Duckle29/0-10V_window_controller/Hardware/images/bot.png

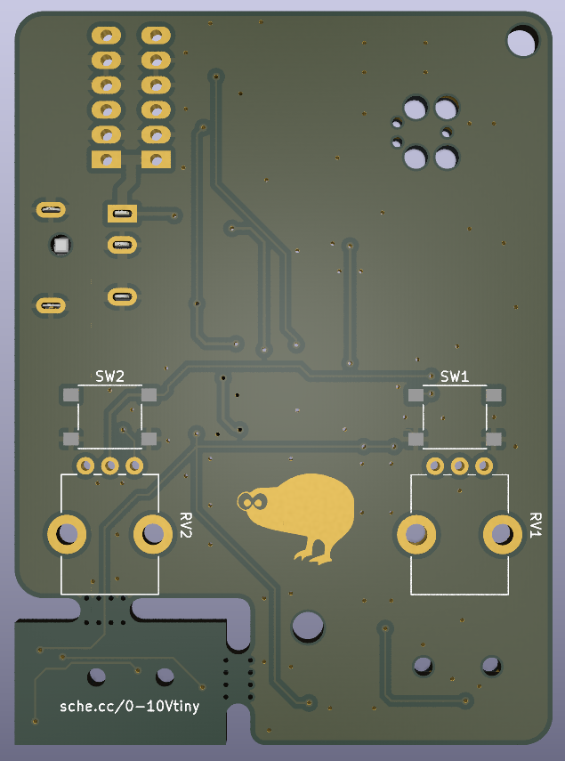
Hardware/images/bot.png
