Duckle29/0-10V_window_controller/Hardware/images/top.png

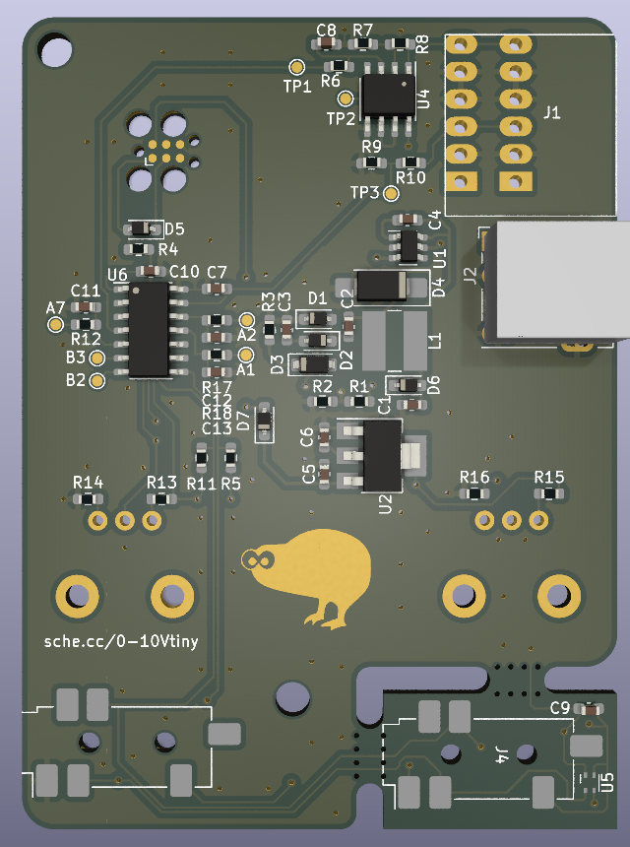
Hardware/images/top.png
