Duckle29/0-10V_window_controller/Hardware/Morten-sol-vindue.pdf

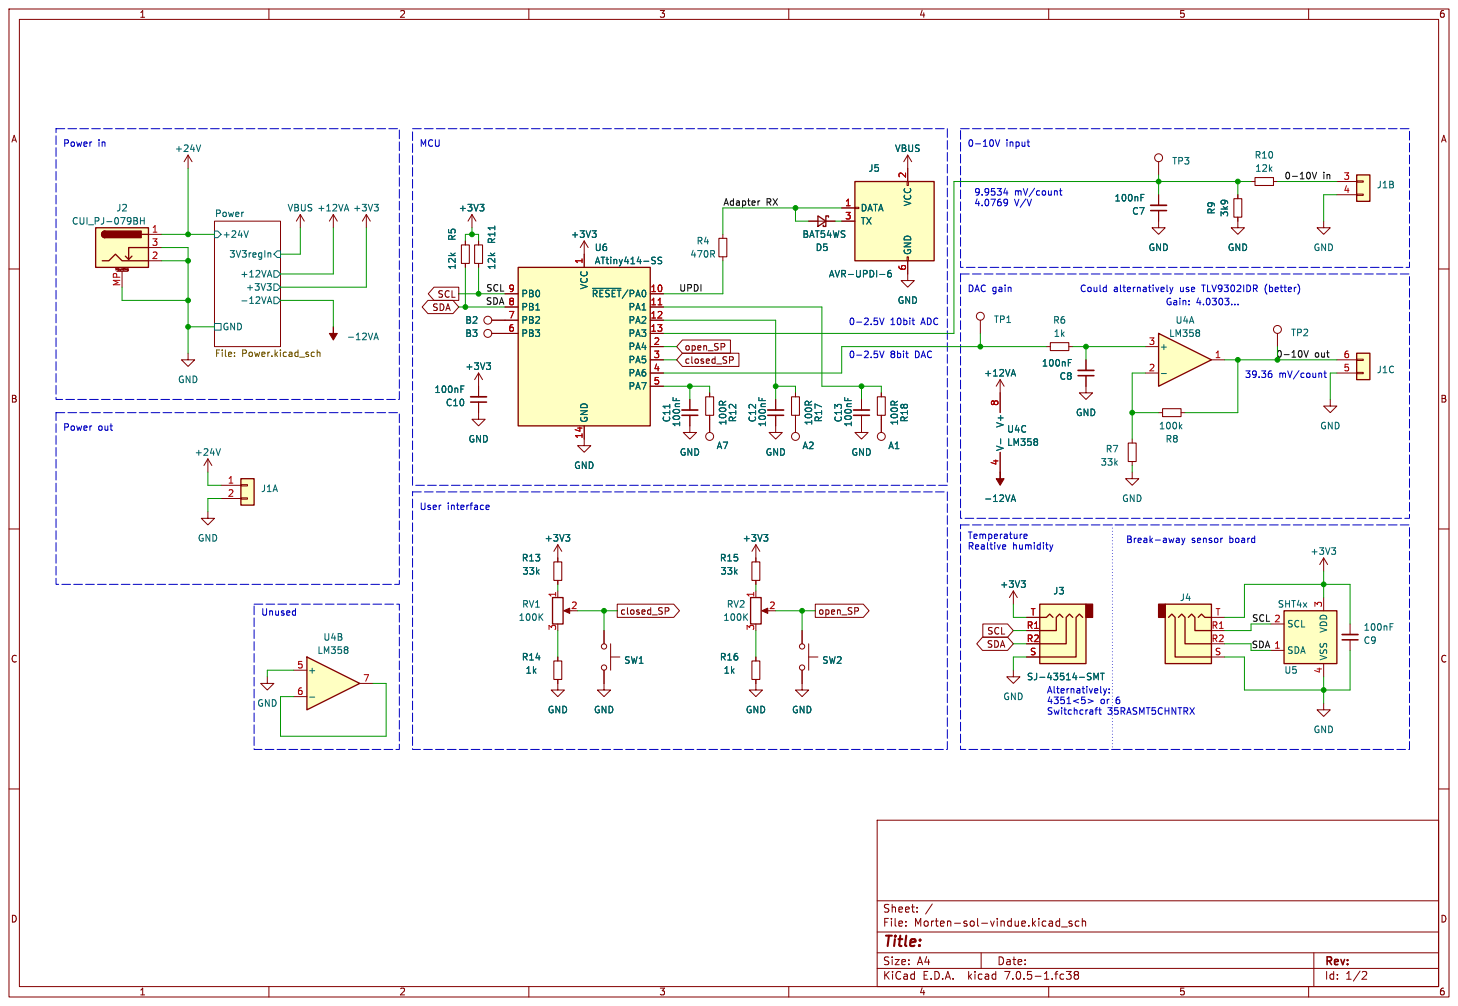
[picture p3: page 1]

Id: 1/2 Title: File: Morten-sol-vindue.kicad_sch Sheet: /

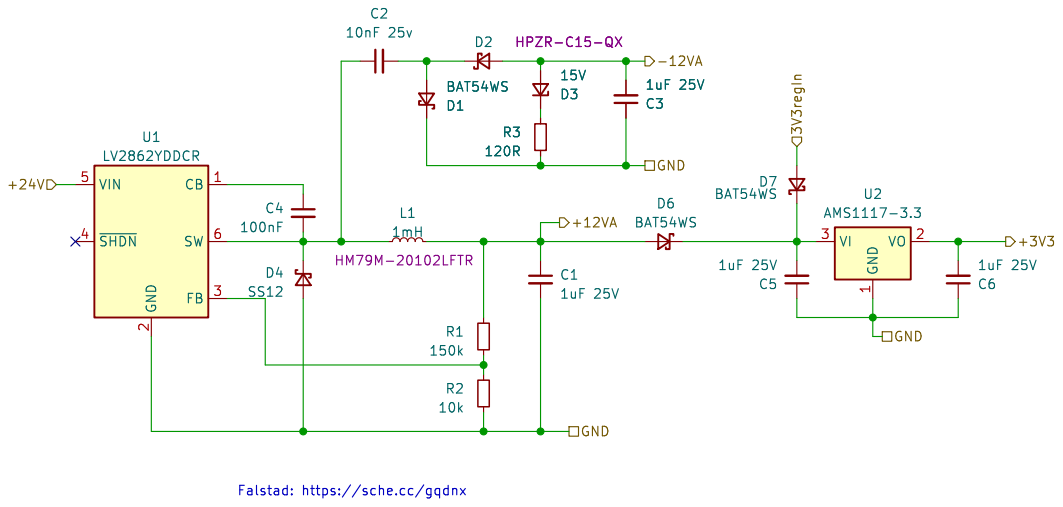
[picture p4: page 2]

2 FB 3 ~{SHDN} 4 VIN 5 SW 6 U1
LV2862YDDCR

Id: 2/2 Title: Power File: Power.kicad_sch Sheet: /Power/ +12V: 10-50mA
