Duckle29/0-10V_window_controller/Hardware/Morten-sol-vindue.kicad_pcb

## KiCad design Hardware/Morten-sol-vindue.kicad_pcb (2023-06-18)

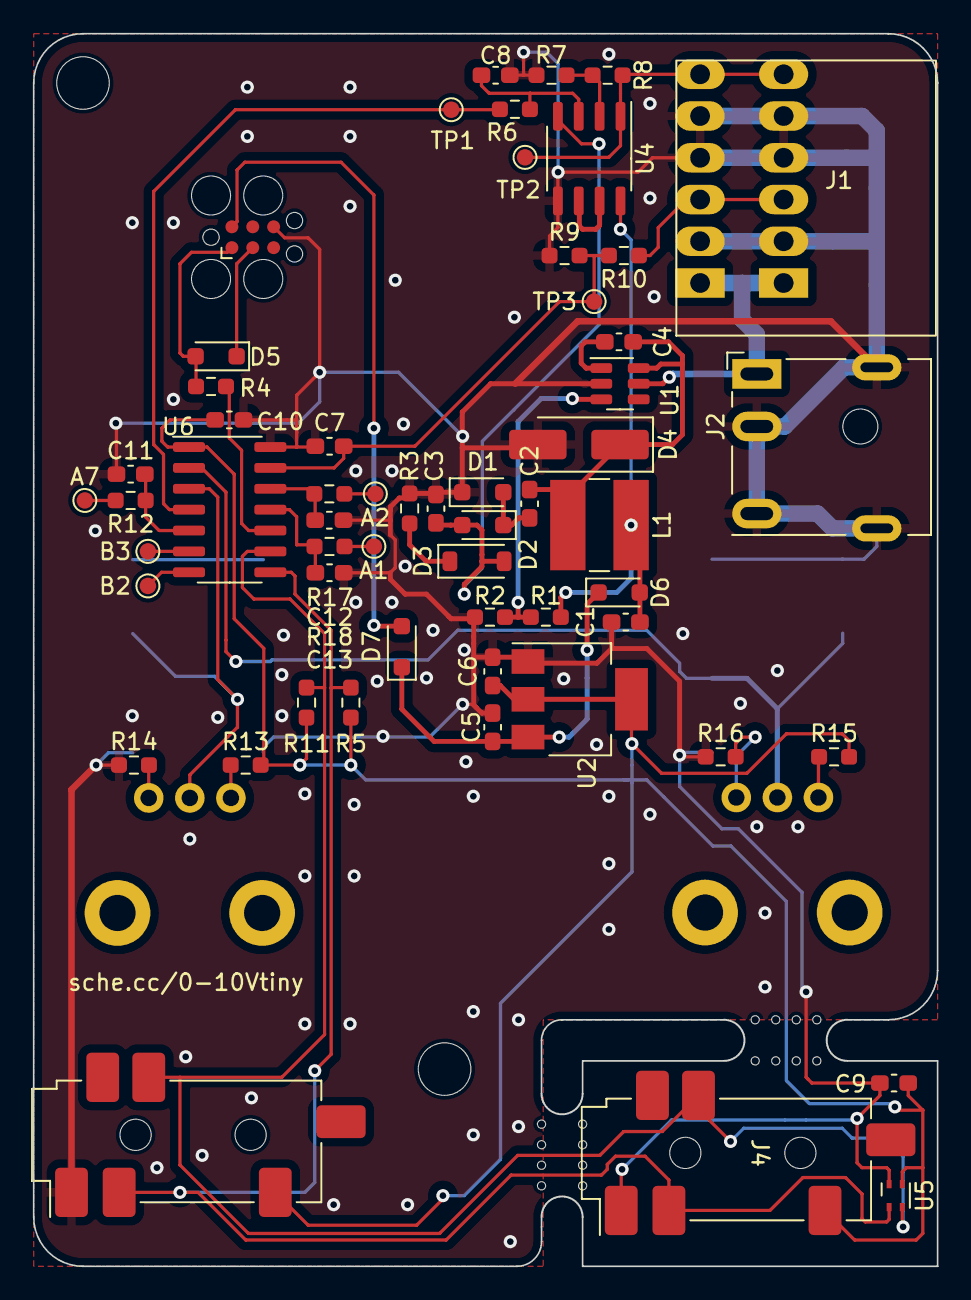
[picture p5: board Morten-sol-vindue.kicad_pcb from above]

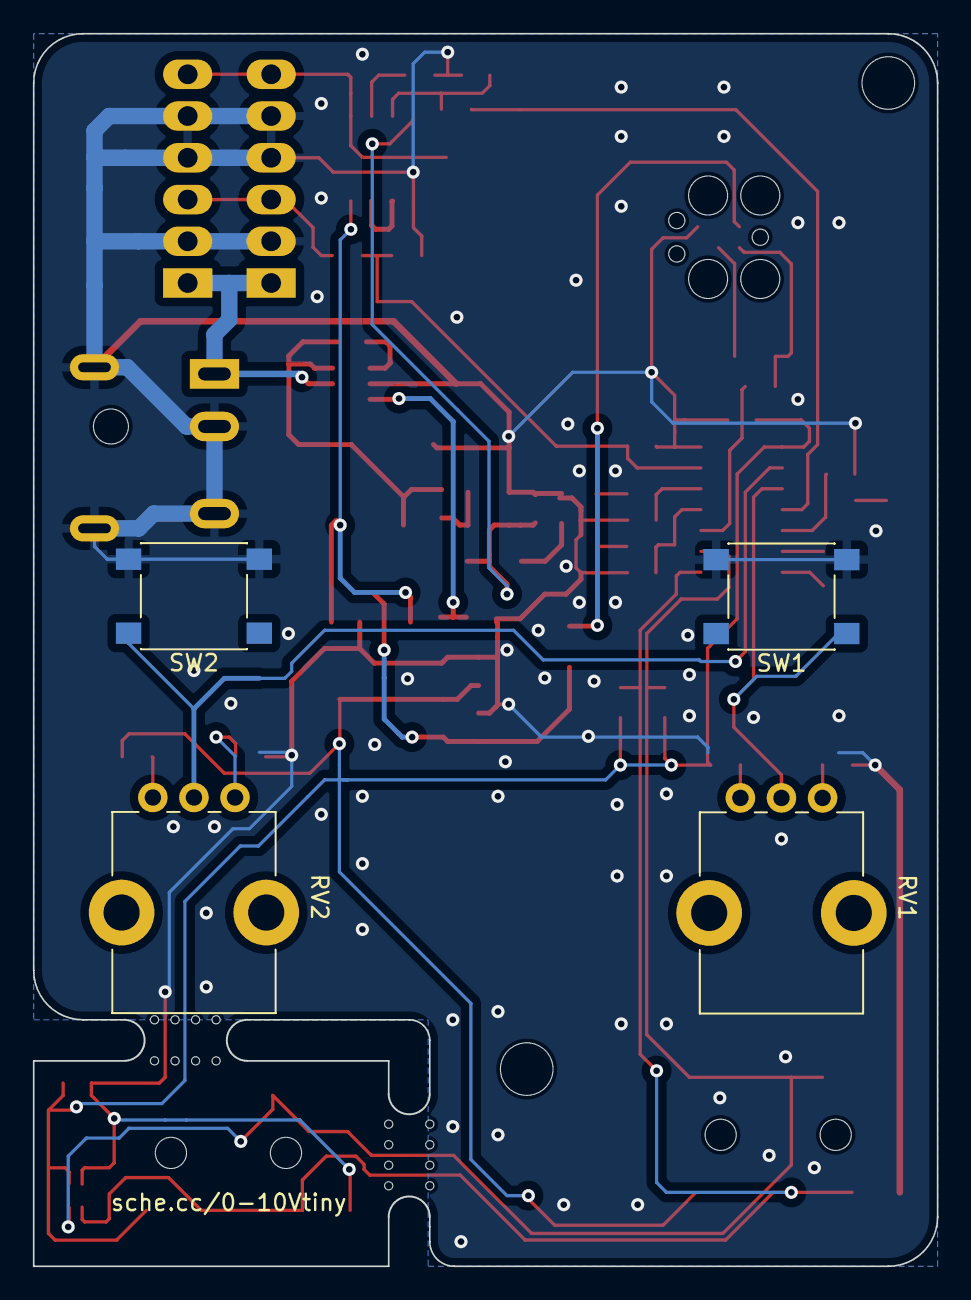
[picture p6: board Morten-sol-vindue.kicad_pcb from below]

Board: 2 copper layers, 55.0 x 75.0 mm, 61 parts (4 on the bottom side), 38 nets.

Parts:
A1, A2, A7: PA7; TestPoint_Pad_D1.0mm
B2, B3: PA7; TestPoint_Pad_D1.0mm
C1, C2, C3, C5, C6: 1uF 25V; C_0603_1608Metric_Pad1.08x0.95mm_HandSolder
C4, C7, C8, C9, C10, C11, C12, C13: 100nF; C_0603_1608Metric_Pad1.08x0.95mm_HandSolder
D1, D2, D5, D6, D7: BAT54WS; D_SOD-323_HandSoldering
D3: 15V; D_SOD-123
D4: SS12; D_SMA_Handsoldering
J1: CUI TBL009-254-06xx; TerminalBlock_Phoenix_PTSM-0,5-6-2.5-H-THR_1x06_P2.50mm_Hor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
J2: CUI_PJ-079BH; BarrelJack_CUI_PJ-079BH_Horizontal
J3: SJ-43514-SMT; Jack_3.5mm_CUI_SJ-43516-SMT_Horizontal
J4: AudioJack4; Jack_3.5mm_CUI_SJ-43516-SMT_Horizontal
J5: AVR-UPDI-6; Tag-Connect_TC2030-IDC-FP_2x03_P1.27mm_Vertical
L1: 1mH; L_TracoPower_TCK-047_5.2x5.8mm
R1: 150k; R_0603_1608Metric_Pad0.98x0.95mm_HandSolder
R2: 10k; R_0603_1608Metric_Pad0.98x0.95mm_HandSolder
R3, R12, R17, R18: 100R; R_0603_1608Metric_Pad0.98x0.95mm_HandSolder
R4: 470R; R_0603_1608Metric_Pad0.98x0.95mm_HandSolder
R5, R10, R11: 12k; R_0603_1608Metric_Pad0.98x0.95mm_HandSolder
R6, R14, R16: 1k; R_0603_1608Metric_Pad0.98x0.95mm_HandSolder
R7, R13, R15: 33k; R_0603_1608Metric_Pad0.98x0.95mm_HandSolder
R8: 100k; R_0603_1608Metric_Pad0.98x0.95mm_HandSolder
R9: 3k9; R_0603_1608Metric_Pad0.98x0.95mm_HandSolder
RV1, RV2: 100K; Potentiometer_Bourns_PTV09A-1_Single_Vertical
SW1, SW2: SW_Push; SW_Push_1P1T_NO_6x6mm_H9.5mm
TP1: DAC; TestPoint_Pad_D1.0mm
TP2: DACx4; TestPoint_Pad_D1.0mm
TP3: A3(0-10/~4); TestPoint_Pad_D1.0mm
U1: LV2862YDDCR; SOT-23-6
U2: AMS1117-3.3; SOT-223-3_TabPin2
U4: LM358; SO-8_3.9x4.9mm_P1.27mm
U5: SHT4x; Sensirion_DFN-4_1.5x1.5mm_P0.8mm_SHT4x_NoCentralPad
U6: ATtiny414-SS; SOIC-14_3.9x8.7mm_P1.27mm

Connections:
+3V3: C6.2, C9.2, C10.2, J3.T, J4.T, R5.1, R11.1, R13.2, R15.2, U2.2 (VO), U5.3 (VDD), U6.1 (VCC)
+12VA: C1.1, D6.2 (A), L1.2, R1.1, U4.8 (V+)
+24V: J1.1, J2.1, U1.5 (VIN)
-12VA: C3.2, D2.2 (A), D3.2 (A), U4.4 (V-)
/0-10V in: J1.3, R10.1
/0-10V out: J1.6, R8.2, TP2.1, U4.1
/Adapter RX: D5.2 (A), J5.1 (DATA), R4.2
/UPDI: R4.1, U6.10 (~RESET/PA0)
GND: C1.2, C3.1, C5.1, C6.1, C7.1, C8.1, C9.1, C10.1, C11.1, C12.1, C13.1, D1.1 (K), D4.2 (A), J1.2, J1.4, J1.5, J2.2, J2.3, J2.MP (MountPin), J3.S, J4.S, J5.6 (GND), R2.2, R3.2, R7.2, R9.1, R14.1, R16.1, SW1.2, SW2.2, U1.2 (GND), U2.1 (GND), U4.5 (+), U5.4 (VSS), U6.14 (GND)
unnamed: A1.1, R18.2
unnamed: A2.1, R17.2
unnamed: A7.1, R12.2
unnamed: C2.2, D1.2 (A), D2.1 (K)
unnamed: D3.1 (K), R3.1
unnamed: C2.1, C4.2, D4.1 (K), L1.1, U1.6 (SW)
unnamed: D5.1 (K), J5.3 (TX)
unnamed: C5.2, D6.1 (K), D7.1 (K), U2.3 (VI)
unnamed: R13.1, RV1.1
unnamed: R14.2, RV1.3
unnamed: R15.1, RV2.1
unnamed: R16.2, RV2.3
unnamed: C4.1, U1.1 (CB)
unnamed: R1.2, R2.1, U1.3 (FB)
unnamed: C8.2, R6.2, U4.3 (+)
unnamed: R7.1, R8.1, U4.2 (-)
unnamed: U4.6 (-), U4.7
unnamed: C13.2, R18.1, U6.11 (PA1)
unnamed: C12.2, R17.1, U6.12 (PA2)
unnamed: C7.2, R9.2, R10.2, TP3.1, U6.13 (PA3)
unnamed: R6.1, TP1.1, U6.4 (PA6)
unnamed: C11.2, R12.1, U6.5 (PA7)
unnamed: B2.1, U6.7 (PB2)
unnamed: B3.1, U6.6 (PB3)
SCL: J3.R1, J4.R1, R11.2, U5.2 (SCL), U6.9 (PB0)
SDA: J3.R2, J4.R2, R5.2, U5.1 (SDA), U6.8 (PB1)
VBUS: D7.2 (A), J5.2 (VCC)
closed_SP: RV1.2, SW1.1, U6.3 (PA5)
open_SP: RV2.2, SW2.1, U6.2 (PA4)
