Duckle29/0-10V_window_controller/(commit log)

2023-05-08 Initial layout
    [Morten-sol-vindue.kicad_pcb, Morten-sol-vindue.kicad_sch]
2023-05-09 Added PCB renders
2023-06-18 Full functionality
    [Morten-sol-vindue.kicad_pcb, Morten-sol-vindue.kicad_sch, Power.kicad_sch]
